shafanoam/TinyCPU/(list of files, drawings)

Other design files:
Noam_FPGA_CPU.circ
