shafanoam/TinyCPU/(commit log)

2023-05-03 Update README.md
    Inserted initial description
2023-05-04 Started the actual assembling system
2023-05-06 First pieces of assembler algorithm
2023-05-08 just uploading whatever changes so school device is up to date
2023-05-17 Actually use github for what it's meant for :/
    [Noam_FPGA_CPU.circ]
2023-05-18 small changes, didn't do much - late start 5-17-23
    [Noam_FPGA_CPU.circ]
2023-05-18 Started updating CPU design after deciding not to use FPGA's
    [Noam_FPGA_CPU.circ]
2023-05-19 Working Text Display
    [Noam_FPGA_CPU.circ]
2023-05-21 WORKING HELLO WORLD PROGRAM :D plus TCASM bugfixes
    [Noam_FPGA_CPU.circ]
2023-05-22 Converted HelloWorld to use variables
    [Noam_FPGA_CPU.circ]
2023-05-22 Added support for offset labels
    By using ..label, label address is offset forward by 1 during assembly, allowing for changing jump addresses more effectively and removing the need for location management.
2023-05-23 Fixed HLT issue
    Due to not ANDing the unhalt with programming mode, it caused an issue where leaving the switch on resulted in erasing every spot in memory. One of the oddest-behaving bugs I've ever seen!
    [Noam_FPGA_CPU.circ]
2023-05-23 Microcode Optimizations Pt. 1
    All register-register instructions now only 4 stages each! From 6 for most and 5 for MOV, that's a roughly 30% improvement in speed!
    [Noam_FPGA_CPU.circ]
2023-05-24 Small (1 cycle) improvement to LDA, STA, and JMP
    [Noam_FPGA_CPU.circ]
2023-05-24 Added repetition to HelloWorld.tcasm
    [Noam_FPGA_CPU.circ]
2023-05-24 RET working, CAL still buggy
    [Noam_FPGA_CPU.circ]
2023-05-25 Fixed CAL instruction
    Lmao both the hardware and testing software had very obvious bugs that both contributed to the issue in their own separate ways
    [Noam_FPGA_CPU.circ]
2023-05-25 Fixed redundant microcode-reset signals
    [Noam_FPGA_CPU.circ]
2023-05-26 Fixed issue with long strings of input
    Basically removed the debouncer as it was no longer actually needed since the input speed was faster than reading speed ;-;
    [Noam_FPGA_CPU.circ]
2023-05-28 .cin now has full backspace support
    [Noam_FPGA_CPU.circ]
2023-05-29 commander.tcasm two commands down
    'die' and 'hi'
2023-05-29 Mild speed improvement
    [Noam_FPGA_CPU.circ]
2023-05-29 Add screen registers and fix carry flag bug
    [Noam_FPGA_CPU.circ]
2023-05-30 Started reverting to tri-state bus
    [Noam_FPGA_CPU.circ]
2023-05-31 Finished the GREAT COMPACTING
    [Noam_FPGA_CPU.circ]
